RuckerMachine/rmkeebs_archive/rm_fullsize/README.md

# RM Fullsize Archive

This directory contains an archive of everything you need to build the RM Fullsize.

The build guide can be found [here](build_guide.md)

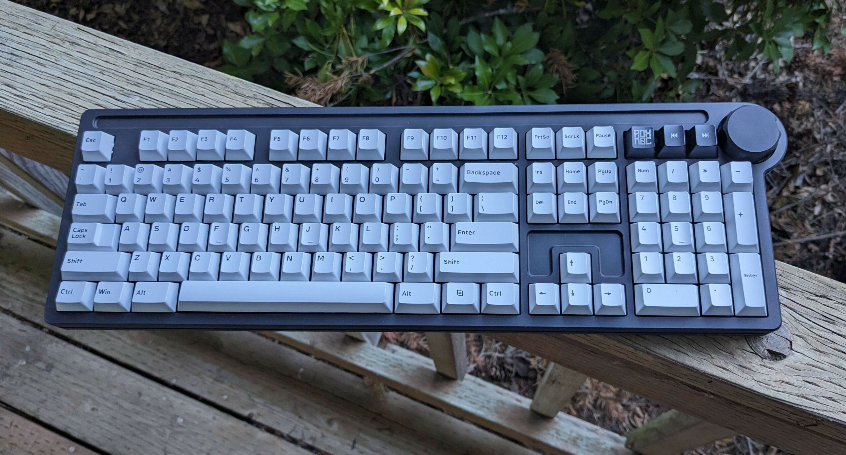
[picture p1: rm_fullsize/images/2.jpg]
rm_fullsize
