RuckerMachine/rmkeebs_archive/rm_numpad/README.md

# RM Numpad Archive

This directory contains an archive of everything you need to build the RM Numpad.

The build guide can be found [here](build_guide.md)

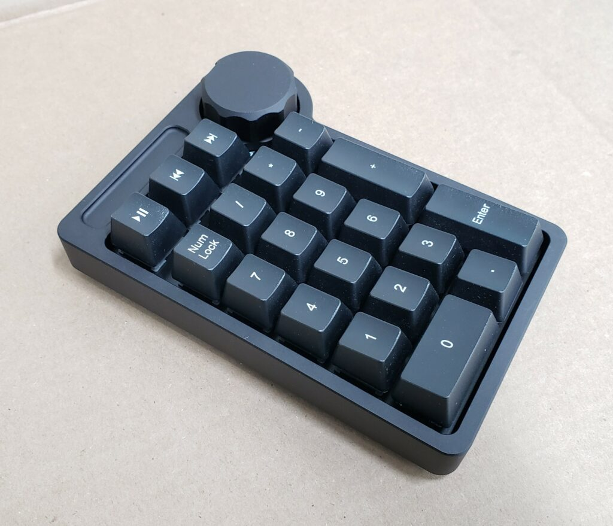
[picture p2: rm_numpad/images/12.jpg]
rm_numpad
