RuckerMachine/rmkeebs_archive/rm_fullsize/plate/full_plate.dxf

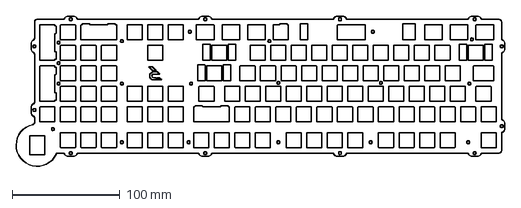
[picture p3: CAD file, 2024-09-15]
rm_fullsize/plate/full_plate.dxf
453.8 x 140.9 mm
