RuckerMachine/rmkeebs_archive/rm_numpad/plate/RM-Numpad plate.dxf

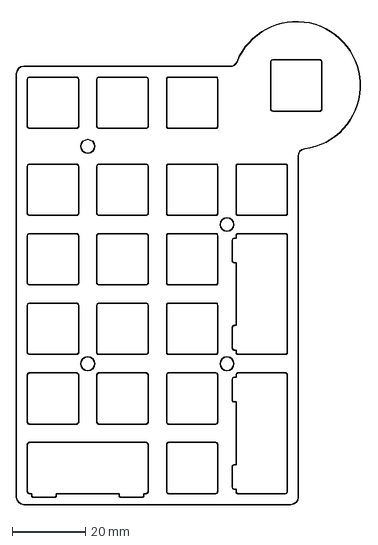
[picture p4: CAD file, 2024-09-15]
rm_numpad/plate/RM-Numpad plate.dxf
94.5 x 133.7 mm
