RuckerMachine/rmkeebs_archive/rm_numpad/STLs/RM-Numpad Foot.stl

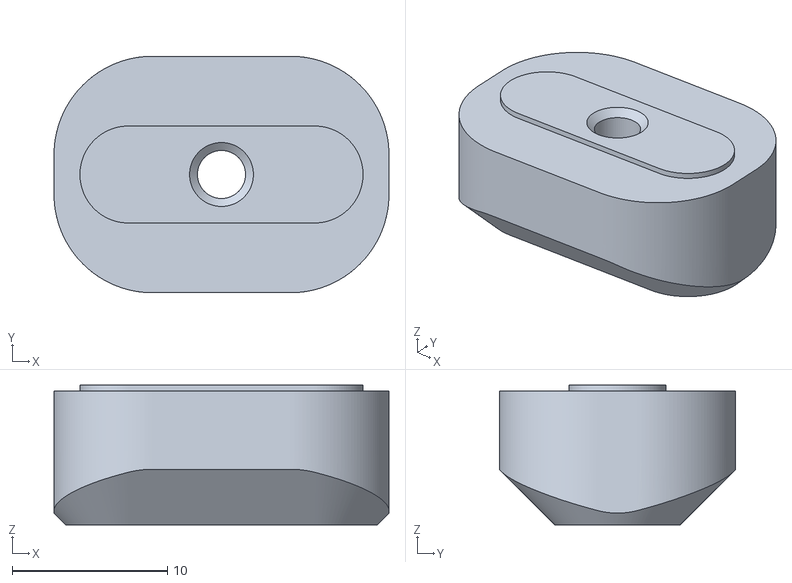
[picture p5: CAD file, 2025-02-20]
rm_numpad/STLs/RM-Numpad Foot.stl
21.6 x 15.2 x 9.02
