RuckerMachine/rmkeebs_archive/rm_numpad/STLs/RM-Numpad Spacer.stl

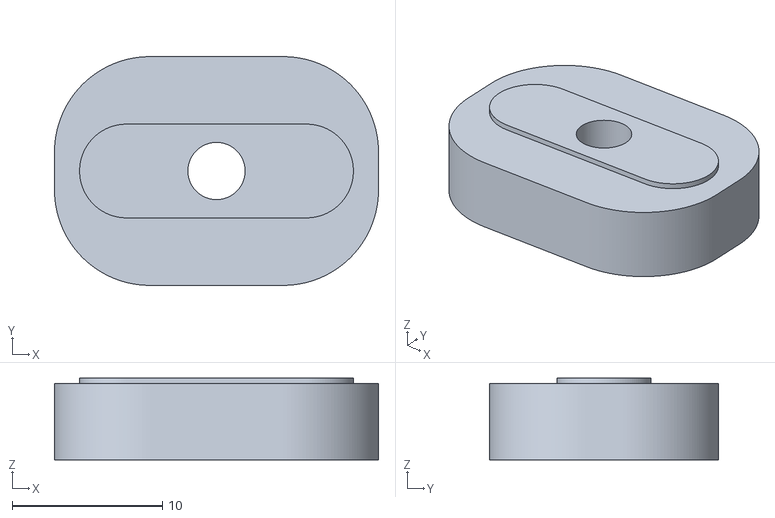
[picture p6: CAD file, 2025-02-20]
rm_numpad/STLs/RM-Numpad Spacer.stl
21.6 x 15.2 x 5.46
