RuckerMachine/rmkeebs_archive/rm_numpad/STLs/RM-Numpad Case.stl

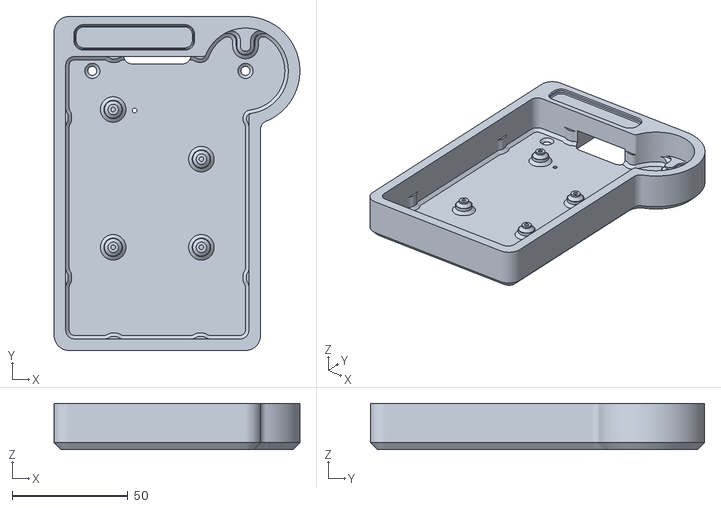
[picture p7: CAD file, 2025-02-20]
rm_numpad/STLs/RM-Numpad Case.stl
106.2 x 144.3 x 20.0
