RuckerMachine/rmkeebs_archive/rm_numpad/STLs/RM-Numpad Knob.stl

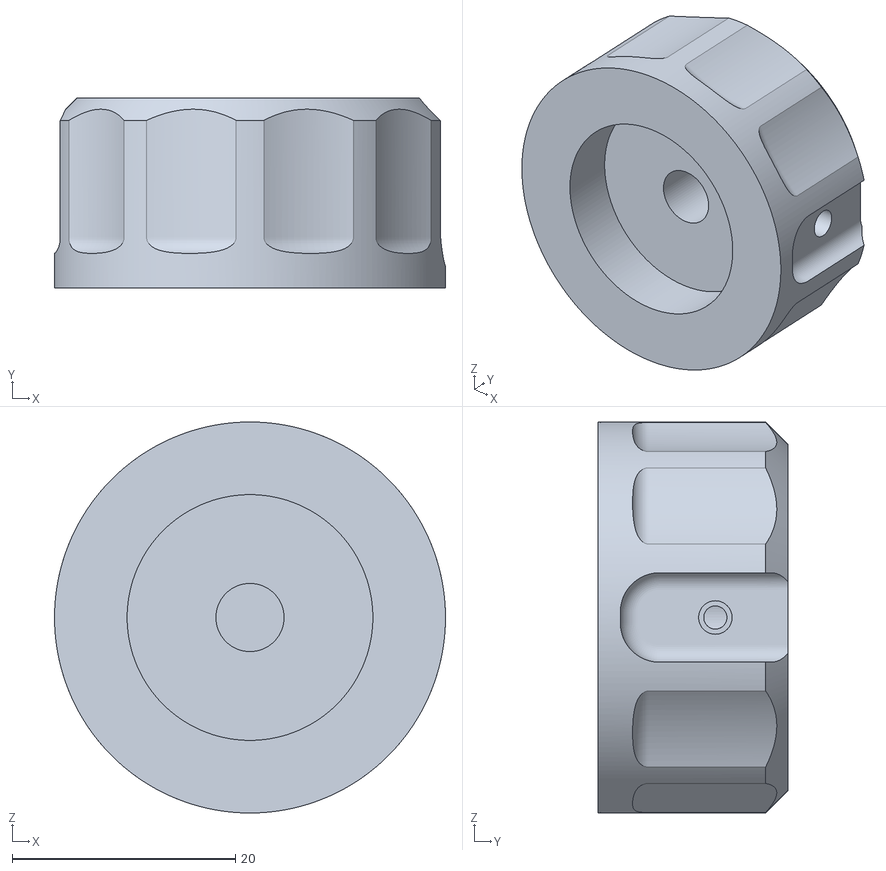
[picture p8: CAD file, 2025-02-20]
rm_numpad/STLs/RM-Numpad Knob.stl
35.0 x 17.0 x 35.0
