RuckerMachine/rmkeebs_archive/(commit log)

2024-09-15 inital commit
    [RM-Numpad plate.dxf]
2024-09-15 adding fullsize
    [full_plate.dxf]
2025-02-20 add stl files
    [RM-Numpad Case.stl, RM-Numpad Foot.stl, RM-Numpad Knob.stl, RM-Numpad Spacer.stl]
